PikoPikoFactory/PikoKeyBeta/Hardware/PikoKeyBeta_schematic.pdf

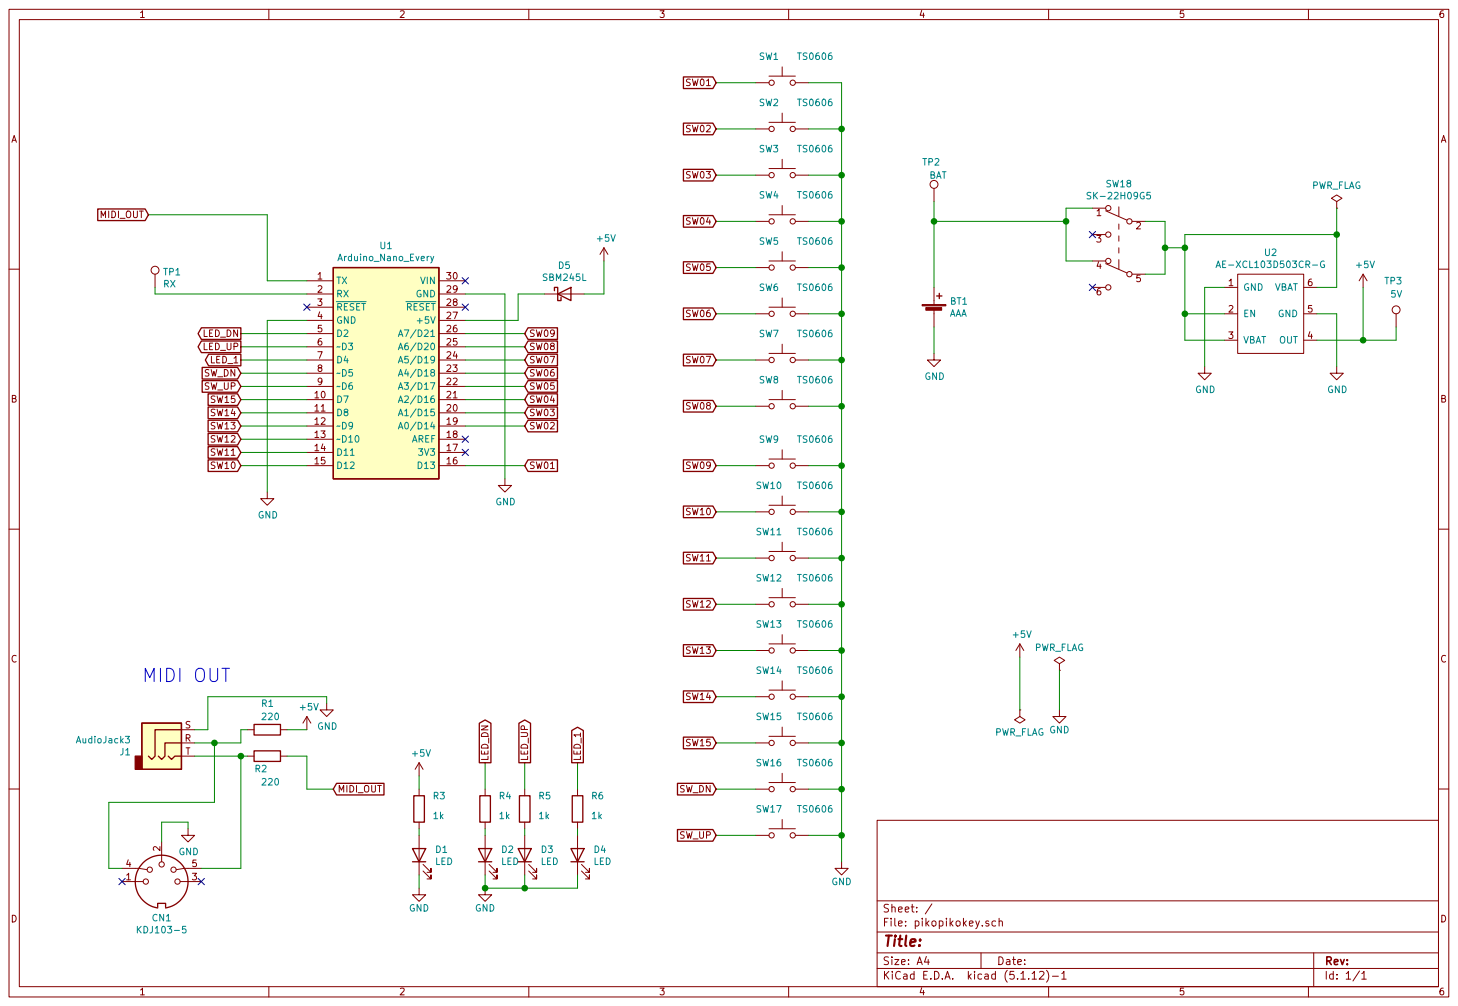
[picture p12: page 1]

File: pikopikokey.sch Sheet: / R6
